GerardoDC14/Pololu-Dual-VNH5019-/arduino/esp32_omni4_base/ControlOmni.h

#pragma once

#include <stdint.h>
#include <math.h>

namespace omni {

// =============================================================================
// LIMITAR
// =============================================================================

inline float limitar(float x, float a, float b) {
  return x < a ? a : (x > b ? b : x);
}


// =============================================================================
// CINEMATICA OMNIDIRECCIONAL
// =============================================================================
//
// Orden fisico fijo: F, I, T, D.
// El frente del robot es la diagonal entre F e I; +lateral apunta entre I y T.
// Los signos son de traccion tangencial, antes de aplicar la polaridad electrica.
// =============================================================================

inline void mezclar(
  float avance,
  float lateral,
  float giro,
  float salida[4]
) {

  salida[0] = avance + lateral + giro;
  salida[1] = -avance + lateral + giro;
  salida[2] = -avance - lateral + giro;
  salida[3] = avance - lateral + giro;


  // Normalizar para que ninguna rueda supere ±1

  float escala = 1.0f;

  for (int i = 0; i < 4; ++i) {

    escala = fmaxf(
      escala,
      fabsf(salida[i])
    );
  }


  for (int i = 0; i < 4; ++i) {

    salida[i] /= escala;
  }
}


// =============================================================================
// CONVERTIR PULSO DEL RADIO A -1 ... +1
// =============================================================================

inline float eje(
  uint16_t pulso,
  int minimo,
  int centro,
  int maximo,
  int zona
) {

  int diferencia =
    static_cast<int>(pulso) - centro;


  // ---------------------------------------------------------------------------
  // Positivo
  // ---------------------------------------------------------------------------

  if (diferencia > zona) {

    return limitar(
      float(diferencia - zona) /
      (maximo - centro - zona),

      0,
      1
    );
  }


  // ---------------------------------------------------------------------------
  // Negativo
  // ---------------------------------------------------------------------------

  if (diferencia < -zona) {

    return limitar(
      float(diferencia + zona) /
      (centro - minimo - zona),

      -1,
      0
    );
  }


  // ---------------------------------------------------------------------------
  // Zona muerta
  // ---------------------------------------------------------------------------

  return 0;
}


// =============================================================================
// HABILITACION
// =============================================================================

struct Habilitacion {

  bool activo = false;

  bool vioOff = false;

  bool anteriorOn = false;


  void actualizar(
    bool valido,
    int pulso,
    bool centrado
  ) {

    if (!valido) {

      activo = false;
      vioOff = false;
      anteriorOn = false;

      return;
    }


    if (pulso < 1300) {

      activo = false;

      vioOff = centrado;

      anteriorOn = false;
    }


    else if (pulso > 1700) {

      if (!anteriorOn) {

        activo = vioOff && centrado;

        vioOff = false;
      }

      anteriorOn = true;
    }


    else {

      activo = false;

      vioOff = false;

      anteriorOn = false;
    }
  }
};


// =============================================================================
// RAMPA DE VELOCIDAD
// =============================================================================

struct Rampa {

  int actual = 0;

  int ultimoSigno = 0;

  uint32_t ceroDesde = 0;


  // ---------------------------------------------------------------------------
  // Cortar inmediatamente
  // ---------------------------------------------------------------------------

  void cortar(uint32_t ahora) {

    if (actual != 0) {

      ceroDesde = ahora;
    }

    actual = 0;
  }


  // ---------------------------------------------------------------------------
  // Avanzar hacia el objetivo
  // ---------------------------------------------------------------------------

  int paso(
    int objetivo,
    uint32_t ahora,
    uint32_t pausa
  ) {

    // Limitar PWM

    objetivo =
      objetivo < -255
      ? -255
      : (objetivo > 255 ? 255 : objetivo);


    int signo =
      objetivo > 0
      ? 1
      : (objetivo < 0 ? -1 : 0);


    // -------------------------------------------------------------------------
    // Si cambia de sentido:
    //
    // primero debe llegar a cero.
    // -------------------------------------------------------------------------

    if (
      actual != 0 &&
      signo != 0 &&
      signo != (actual > 0 ? 1 : -1)
    ) {

      objetivo = 0;
    }


    // -------------------------------------------------------------------------
    // Pausa después de llegar a cero
    // -------------------------------------------------------------------------

    if (
      actual == 0 &&
      signo != 0 &&
      ultimoSigno != 0 &&
      signo != ultimoSigno &&
      uint32_t(ahora - ceroDesde) < pausa
    ) {

      return 0;
    }


    int previo = actual;


    // -------------------------------------------------------------------------
    // Acercarse al objetivo
    // -------------------------------------------------------------------------

    if (actual < objetivo) {

      ++actual;
    }

    else if (actual > objetivo) {

      --actual;
    }


    // -------------------------------------------------------------------------
    // Detectar llegada a cero
    // -------------------------------------------------------------------------

    if (
      actual == 0 &&
      previo != 0
    ) {

      ceroDesde = ahora;
    }


    // -------------------------------------------------------------------------
    // Guardar último sentido
    // -------------------------------------------------------------------------

    if (actual != 0) {

      ultimoSigno =
        actual > 0
        ? 1
        : -1;
    }


    return actual;
  }
};

} // namespace omni
