GerardoDC14/Pololu-Dual-VNH5019-/(commit log)

2026-09-12 Documenta control serial de M1, pinout y rampas con ESP32
2026-09-12 Agrega borrador RC para cuatro omni y documenta cinematica y cableado
2026-09-28 Actualiza control PPM y agrega pulso de solenoide
2026-09-28 Agrega control orientado al campo con IMU
2026-09-29 Define diagonal front kinematics for omni base
2026-09-29 Fix kinematics math rendering
2026-10-12 Add Arduino code changes
2026-10-22 Agregar configuraciones en + y x sin IMU
2026-10-22 Configuraciones sin IMU
